AGCCS/AGCCS-CTRL22/ctrl22c/README.md

# Ctrl22C --- AVR Firmware

Our firmware for the AVR uC ATmega4808 controls the charging process according to the CCS standard. For details of the circuitry, see [../circuit](../circuit/).  The code is organised in a cyclic fashion, i.e., there is one indefinite while-loop which runs a number of callback functions to actually operate the attached hardware modules (e.g. generate control pilot CP, read back CP, read proximity pilot PP, operate mains relays, measure current, etc.). The firmware is controlled via the TX0/RX0 serial line with a line-based human-readable protocol. In our project, this control is exercised by an ESP32 SoC to allow for remote access. For first installation, we propose to set the ESP32 in target AVR development mode in order to transparently forward the AVR's TX0/RX0 via telnet; again, see [../circuit](../circuit/) for details.

## Organization of the Charging Process

The established way to charge an EV according the relevant CCS specification is organised in three stages: 

- (A) wait for the motorist to plug in the cable;
- (B) lock the charging cable, indicate available power, and wait for the EV to be ready to charge;
- (C) forward the mains power to the EV

If the maximum available mains current and the allocated phases do not change, this is exactly how our firmware behaves. However, when allocating the power dynamically, we need to take some extra precautions. The below proposal is an early draft and we expect some further tweaks to be required. To this end, it should work out fine for static power allocation.

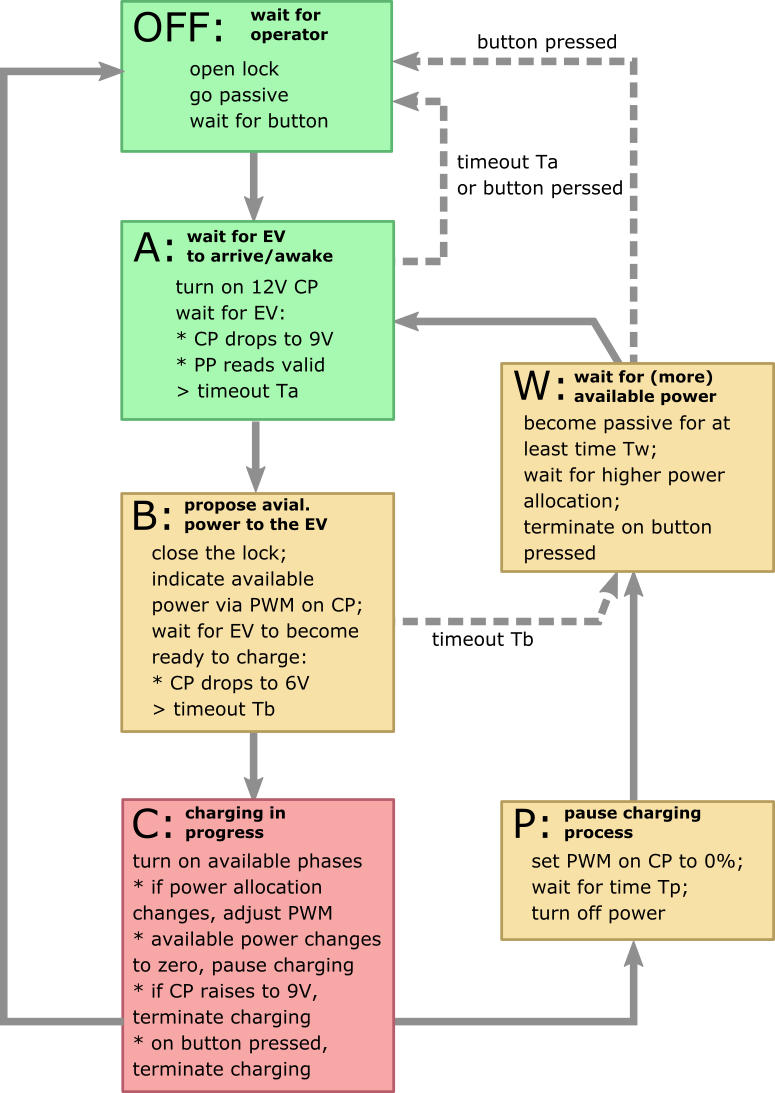
[picture p3: images/ccsfsm.png]


You can inspect the implemantation of this state machine in the callback function `ccs_cb()`. A typical cycle time of our main loop is about 5ms depending on the workload, the maximum should be below 10ms. As indicated above, the individual components are again addressed via callback functions. That is, whenever `ccs_cb()` e.g. needs to know whether the operator button has be pressed, it will read the global variable `g_button` and trust the respective callback function `button_cb()` to set this variable accordingly. By convention, global variables are prefixed `g_` and callback functions are suffixed `_cb()`. The main indefinite while loop consists of a list of callback functions which interact via dedicated global variables, i.e., the relevant state of the overall program.

- `systime_cb()` updates  `uint16_t g_systicks` to a system time in ms ticks with a convenient rollover at 2^16-1; we use `g_systicks` extensively to schedule timeouts without getting locked; there is also a variant `g_systime` with a rollover at 30000 to facilitate a synchronisation of seconds;                                     

- `monitor_cb()` is for debugging purposes, it monitors the maximum cycle time so that we can be sure to be below whatever our requirements at this end are;

- `led_blinks_cb()` outputs a flash pattern to the operator LED with a 2 second period to indicate relevant aspects of the CCS state to the customer. I.e., a single short flash at 0.5Hz for "OFF" , a 1Hz relaxed blinking for "negotiating power allocation" and a constant on for "charging". This can be overwritten via the serial line protocol.  

- `lock_cb()` operates the lock accroding to `g_lock_st`; the latter is an enum to encode `open`, `closing`, `closed` and `opening`; for convenience, there is a setter `lock(1)` to initiate closing and `lock(0)` to initiate opening; the callback then operates the solenoid according to its schedule; 

- `button_cb()` sets `g_button` to `true` when a positive edge has been detected; it will be reset in the subsequent loop;

- `rms_cb()` keeps updating the RMS measurement of the actual current; it triggers a 10kHz interrupt to take samples and subsequently organises RMS computation in short slices; eventually, `g_cur1`, `g_cur2` and `g_cur3` will be updated accordingly; the convenenience functions `rms(1)` and `rms(0)`  enable and disable RMS periodic measurement, respectively.

- `pilots_cb()` keeps updating synchronous analog reading of pilots to` g_cpilot` (scaled in [V]) and `g_ppilot` (conveniently scaled in [100mA]); again, pilot reading is enabled/disabled by  `pilots(1)`/`pilots(0)`;

## Serial Line Protocol

A relevant subsets of the state variables can be read from or written to via the serial line. It is set to 115200 8N1 and is physically accessible via J4 or, more conveniently, via telnet and the ESP32 in target development mode; see also [../citcuit](../circuit). The protocol is as follows.

- to read the parameter `<PAR>`, send `<PAR>?\r\n` to the AVR; expect a reply in the form ` <PAR>=<VAL>\r\n`, or `parse error\r\n` for a parse error; here `<PAR>` is the printable-ASCII name of the parameter and `<VAL>` is a signed 16bit integer in common decimal ASCII representation;
- to write the parameter `<PAR>`, send `<PAR>=<VAL>\r\n` to the AVR; expect a reply in the form ` <PAR>=<VAL>\r\n`, or  `parse error`; here `<PAR>` and  `<VAL>`  are ASCII encoded name and value of the respective parameter as indicated above;
- semantic suger: send `<PAR>!` to set the value to `1`, or  `<PAR>~` to clear the value to `0`.

The protocol is strictly line based. That is, the host sends one line and expects one line as reply. This is to facilitate parsing on host side, which in our use case is done by the attached ESP32.

###### Examples for the purpose of dynamic power allocation

| Send to AVR | Receive from AVR  | Comment |
| --- | --- | :--- |
| `ver?/r/n` | `ver=14/r/n` | read firmware version v1.4 |
| `cmaxcur?/r/n` | `cmaxcur=160/r/n` | read charging cable capacity 16.0A (-1 for no cable detected) |
| `smaxcur=160/r/n` | `smaxcur=320/r/n` | set maximum available current to 32.0A |
| `amaxcur?/r/n` | `amaxcur=160/r/n` | read maximum current actually allocated to the vehicle |
| `phases=12/r/n` | `phases=12/r/n` | enable mains phases L1 and L2 (i.e., decimal encoding) |
| `cur1?/r/n` | `cur1=65/r/n` | read 6.5A as current drawn on phase L1; likewise phases L2 and L3 |

**Conventions.** Current is throughout communicated by integers in the unit [100mA], i.e., fixed point representation with one decimal place when interpreted as [A]. Selection of any subset of the three phases L1, L2 and L3 is "decimal encoded", i.e., those decimal digits present in the parameter are selected. E.g., "123" reads "all three phases", "32" and "23" both read "phases L2 and L3", and "0" reads "no phases".   

Optional convenience commands are implemented on top of the strict set/get-parameter scheme. The AVR reply on such a command is escaped with a beginning line `[[[\r\n` and trailing line `]]]\r\n`. Currently, there is only one such convenience command, namely `?\r\n` to request an overall system status and the overall list of accessible global variables; see also below. 

For the sake of simplicity, the AVR is passive, i.e., if we want a regular update on some aspects of its state, we need to poll. Exceptions are

- various debug switches in our current firmware revision will generate informative lines of unsolicited rumble that begin with the special character `%`
- for future revisions, we may send relevant status updates (e.g. drawn current) by single lines that begin with the special character `[` and that end with `]/r/n`.

Thus, the ESP32 firmware shall filter any lines that start  `%` an optionally interpret lines that start with `[` .

##### List of accessible parameters as obtained by `?\r\n`

```
=======
AGCCS-Ctrl22C AVR Firmware Version 1.3
Copyright Thomas Moor (c) 2020, 2021
=======
ver=13      [R/-] % read out firmware version
blinks=-1   [R/W] % overwrite status indicator
time=1634   [R/W] % read/set systime in [ms]
temp=30     [R/-] % read AVR die temperatur [C]
vcc=3328    [R/-] % read AVR VCC [mV]
ccss=33     [R/-] % read CCS state, see typedef "ccs_state_t"
cmaxcur=320 [R/-] % read PP, i.e., max. cable capacity [100mA]
amaxcur=160 [R/-] % read max. current signaled to EV via CP [100mA]
cur1=86     [R/-] % read current drawn on L1 [10mA]
cur2=0      [R/-] % --- dito for L2
cur3=0      [R/-] % --- dito for L3
error=0     [R/-] % read error flags, see declaration "g_error"
save        [-/W] % use "save!" to save configuration to EEPROM
smaxcur=160 [R/W] % read/write max. current available from source [100mA]
brdrev=12   [R/W] % set/get board revision
ccsdmp      [-/W] % use "ccsdmp!" to track CCS state progress
phases=123  [R/W] % read/write available phases [decimal encoding]
sigrel      [-/W] % use "sigrel!"/"sigrel~" to en/disable the signal relay
pilots=1    [R/W] % use "pilots!"/"pilots~" to en/disable periodic pilot reading
cpilot=6    [R/-] % read CP [V]
cpdtest=12  [R/-] % read CP on  nagativ halfwave [-V]
ppilot=320  [R/-] % read PP (same as cmaxcur)[100mA]
cpcur=160   [R/W] % read/write max. current indicated to the EV via PWM on CP
rms=1       [R/W] % use "rms!"/"rms~" to en/disable periodic current reading
rms1=74     [R/W] % get rms reading of CT1 [mV], use "rms1!" to trigger update
rms2=3      [R/W] % --- dito for CT2
rms3=3      [R/W] % --- dito for CT3
rmsdmp      [-/W] % dump most recent rms record
caldmp      [-/W] % use "caldmp!" for periodic dumps of RMS counts (req. "rms!")
cala=1126   [R/W] % read/write calibration parameter cA
calb=271    [R/W] % read/write calibration parameter cB
lock        [-/W] % use "lock!"/"lock~" to operate the lock
lopnms=100  [R/W] % read/write pulse length to open lock [ms]
lclsms=100  [R/W] % read/write pulse length to close lock [ms]
ssr         [-/W] % operate contactors (dec. encoded), use "ssr~" for "all off"
reset       [-/W] % use "reset!" for a soft reset
=======
```

## First Installation

The firmware supports some commands via the serial line that are specifically meant to facilitate first installation. For this purpose, it is recommended to power the circuitry from a 12V bench supply and to test individual functional modules separately with dedicated test peripherals attached.

**Serial Line.** Whether physically attached via J4 and an USB-to-Serial converter (set 1o 115200 8N1)  or whether using telnet via the ESP32, enter `?\r\n` and observe the above parameter summary to verify serial communications.

**Operator LED.** Connect the LED anode to +12V and the cathode via a suitable resistor to the LED-terminal; 500R should be fine for a "standard" 2V/20mA red LED. On power up, the device will blink at a 2sec period to indicate its status. When observing continuously flashes at high frequency, this indicates an error state. On first-installation, the reason is presumably an EEPROM checksum error. This is to be fixed by saving the default parameters (command `save!\r\n`) . 

**Operator Button.** Connect the button to +12V and to the BTN-terminal. On button press, the firmware transitions to EV detection. This is indicated by changing the blink pattern of the LED to a smooth 0.5Hz blink. Since there is no EV connected, the device will go to an error state after timeout.

**Signal Relay.** By default, the signal relay is off. To turn it on, use  `sigrel!\r\n`. This is required for the following tests of the proximity signals. You should now observe +12V at the CP-terminal.

**Proximity Pilot.** Enable periodic pilot reading by `pilots!\r\n`. If nothing further is connected, `cmaxcur?\r\n` should read 130 (i.e. 13.0A). When connecting the PP-terminal via a 220R resistor to ground, `cmaxcur?\r\n` should read 320 (i.e. 32.0A). In the case the `DEBUG_ADC` macro is defined, the periodic reading of all pilots will be forwarded to the serial line, incl. the actual ADC count.

**Control Pilot (reading).** Enable periodic pilot reading by `pilots!\r\n`. If nothing further is connected, `cpilot?\r\n` should read 12 (i.e. 12V). When connecting the CP-terminal via a diode and a resistor 2.7K to ground,`cpilot?\r\n` should read 9 (i.e. 9V). When adding a 1.3K resistor in parallel `cpilot?\r\n` should read 6 (i.e. 6V). The voltage readings should match the voltage at the CP-terminal, i.e., use a meter to check back. 

**Control Pilot (generating)**. Use e.g.  `cpcur=60\r\n` to generate a 1kHz PWM signal corresponding a maximal current of 6A, which should amount to 10% duty cycle. Likewise, use  `cpcur=300\r\n` to expect a duty cycle of 50%. The amplitude should be +/-12V. Use a scope to check back. If nothing further is connected, `cpilot?\r\n` should read 12 (i.e. 12V). When connecting a diode and a resistor to the CP-terminal as described above, only the positive half wave should be affected.

**Lock.** The lock terminals W and R should be at 12V when passive. When closing the lock by  `lock!\r\n` the W terminal drops to 0V for about 100ms. If no lock is connected, this will result in a lock-error. Use   `reset!\r\n` to reset the device if you want to repeat the test. Before connecting a lock, figure the wiring (color codes differ from lock to lock). For opening the lock, use  `lock~\r\n`.

**Current Reading (A).** Use `caldmp!\r\n` to from now on forward RMS readings incl. the ADC count to the serial line. Use  `rms1!\r\n` to trigger a single reading of the RMS value for mains phase 1. The respective terminals are CT-L1 and CT-K1. Here, CT-K1 is a 1.65V bias (check with a meter) and CT-L1 is the AC signal induced by the current transformer. If nothing is connected we expect to read zero modulo noise, typical values observed are no more than 3 ADC counts.  For further testing, you may attach a signal generator with a 50Hz sine and e.g. 100mV amplitude, and check for `rms1?\r\n` to read 71 (i.e. 71mV RMS). There are two cases for consideration. If the signal generator is not grounded, you may connect directly to the CT-L1 and CT-K1 terminals. If, on the other hand, the generator is grounded, you should connect live to CT-L1 and the generators ground to GND. For this situation, you need to configure the generator to produce a 1.65V offset --- otherwise, the negative half-wave may damage the ADC in the AVR. Recall that built-in signal-generators in scopes are usually grounded. Double check the wiring and use serial resistors when connecting a signal generator to the device. 

**Current Reading (B).** The conversion from RMS in ADC counts to RMS in mV is done by the books with no calibration and we expect this to be slightly off --- the mV reading is for informative purposes only anyway. For our application, the conversion from RMS in ADC counts to RMS in multiples of 100mA is the only concern. This is implemented as an affine transformation "current [100mA]= counts x A + B".   Simple example: when reading 147 in ADC counts at an actual current of 16.2 A we may set "A=10 x 16.2 / 147" and "B=0". More advanced: reading Count1 for Current1 and Count2 for Current2, we solve "10 x Current1 = Count1 x A + B" and "10 x Current2 = Count2 x A + B" to obtain A and B. Using binary fixed point representation, the parameters A and B are specified as p_cala and p_calb in multiples of 1/1024, i.e., we finally set "p_cala=1024 x A" and "p_calb=1024 x B". For calibration you will need a full setup including the current transformers, an external current meter, and an actual load; see also [calibration](../doc/current_reading_calibration_2021_05.pdf).  

**SSRs.** To test the SSRs you will need to run the device on mains (caution!). `ssr=1\r\n` should turn on the SSR for phase 1, `ssr=123\r\n` should turn on all SSRs, `ssr~` should turn all off.   When contactors are  connected to the respective terminals Cx-N and Cx-L, they should be operated accordingly. This part of the circuitry is fairly simple and should need no further attention. We recommend not to test the SSRs beforehand and to defer this step until the entire unit is safely placed within an enclosure and contactors are attached.

**Simulating a Charging Cycle.** For a minimum setup to simulate a charging cycle, you need to install at least one contactor and one current transformer and wire this to drive some load. Since this is all on mains, installation in a proper enclosure is mandatory, incl. a CEE plug for power supply and a CCS outlet;  see [Installation](../Installation.md) for details on the external components and the wiring.  Most conveniently, you will setup an adaptor with a CCS plug on the one end such that the active phase is forwarded to an household mains outlet so you can attach a load (e.g. an electric heater). Furthermore, the adaptor should let you manually mimic the EV state via the CP line (see also above _CP reading_). Our overall setup is as follows:

```
                 external current meter  
============+                V                                           +=====
AGCCS board,|-> CCS L1 >-----O------------------> household outlet L1 --->|   
contactor,  |-> CCS N  >------------------------> household outlet N  --->| load
fuses,      |-> CCS PE >-----------------+------> household outlet PE --->|
CEE supply, |                            |                               +=====
installed   |-> CCS CP >--+--[/]--[2K7]--+ 
in a proper |             |              |
enclosure   |             +--[/]--[1K3]--+
============+             |
                          V
                    attach scope here

```

There is professional gear available for this purpose, however, at a substantial cost. At this stage it is highly recommended to connect with telnet via the ESP32 in target debug mode to access the serial line of the AVR wirelessly. Use `ccsdmp!\r\n` to observe the progress through the CCS states. Optionally, attach a scope as indicated to observe the PWM signal on the CP line. To calibrate the internal current reading, use  `caldmp!\r\n` (see also above) and compare with an external meter. 

## Compiling/Programming the AVR

We provide a `Makefile` that should be easily adaptable to Linux/MacOSX programming environments. The easiest way to get a recent AVR toolchain is to install the Arduino IDE and to figure the path of the relevant binaries. A simple `make` on the command line will then produce the binaries `ctrl22c.bin` and `ctrl22c.hex`. The former is required when updating firmware over the wireless mesh network (see [../demesh](../demesh/)), the latter when using `avrdude` via telnet or the J4 header (see [../circuit](../circuit/))

The code itself has a number of debug switches right at the beginning which we use for "serial line debugging". If e.g. there are issues with the lock, it is worth turning on `#define DEBUG_LOCK`.
