AGCCS/AGCCS-CTRL22/images/installation.pdf

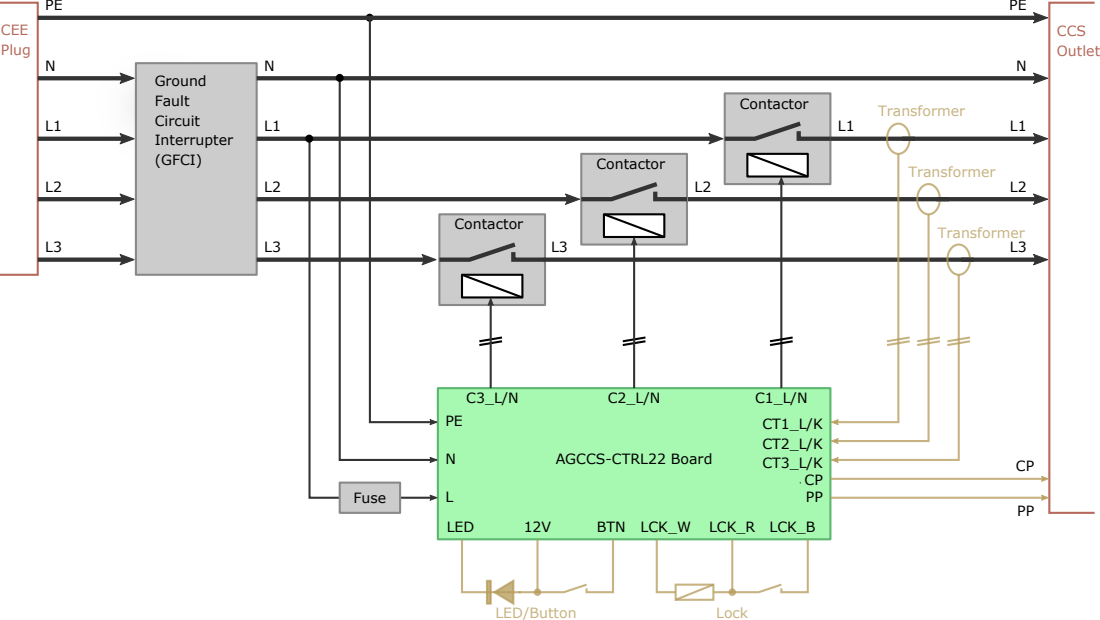
[picture p47: page 1]
Ground Fault Circuit Interrupter (GFCI); CEE Plug; Contactor; AGCCS-CTRL22 Board; CCS Outlet; LED/Button; Lock; LED; BTN; Fuse; LCK_W LCK_R LCK_B; Transformer
