AGCCS/AGCCS-CTRL22/images/installationx.pdf

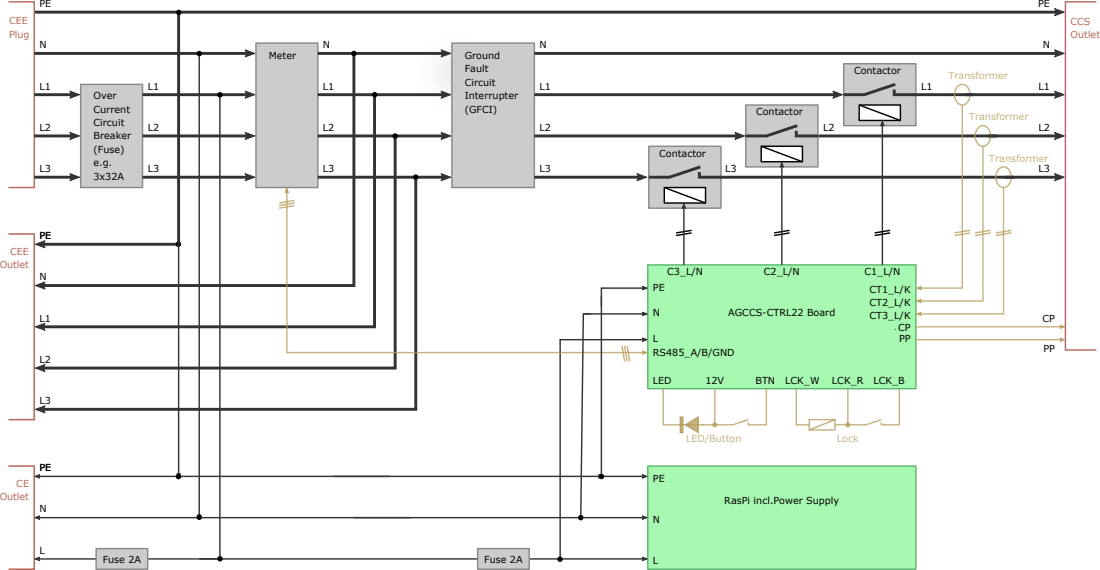
[picture p48: page 1]
Ground Fault Circuit Interrupter (GFCI); Contactor; AGCCS-CTRL22 Board; CCS Outle; PENL; C1_L/N LED/Button; Lock; LED; BTN LCK_W LCK_R LCK_B; CEE Plug; Over Current Circuit Breaker (Fuse) e.g. 3x32A; Meter; CEE Outlet; RS485_A/B/GND; PEN; CE Outlet; Fuse 2A

RasPi incl.Power Supply
