AGCCS/AGCCS-CTRL22/circuit/agccs-j5adaptor-schematic.pdf

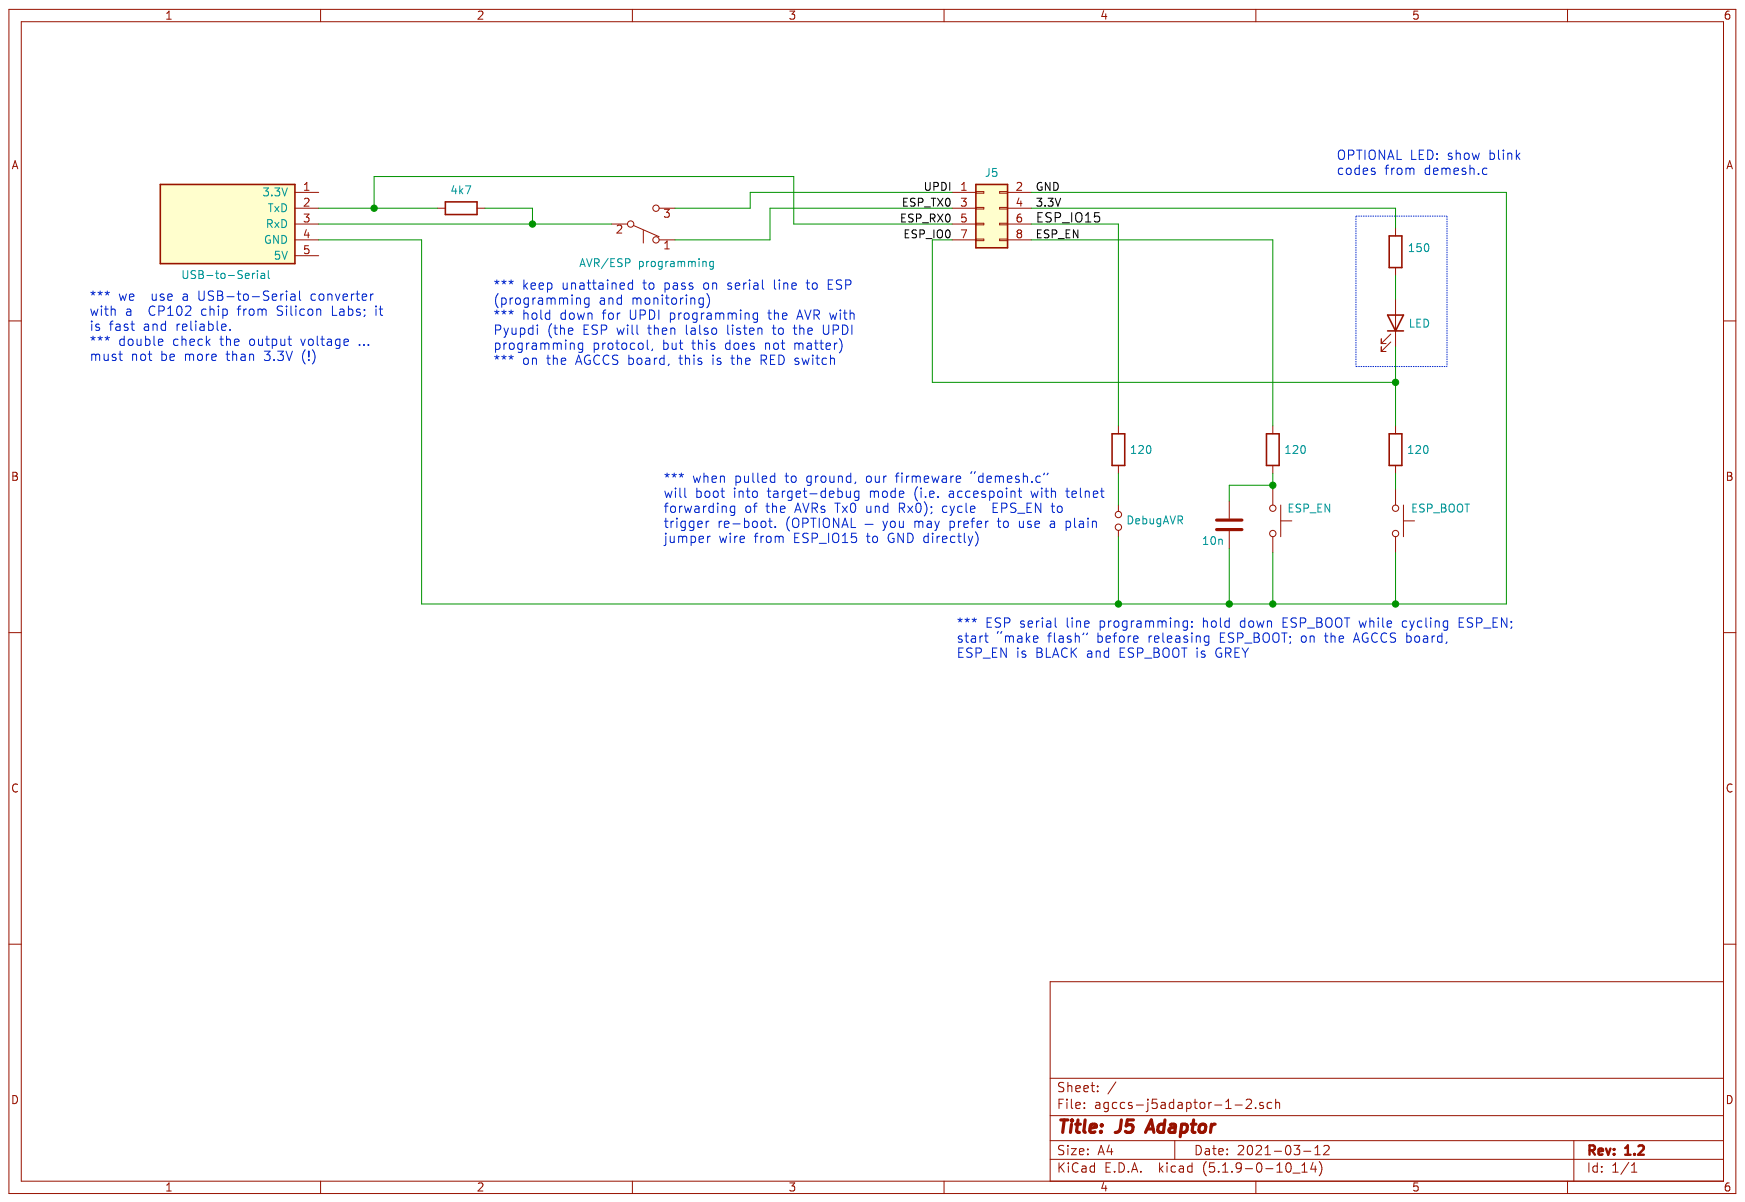
[picture p53: page 1]
