AGCCS/AGCCS-CTRL22/circuit/agccs-ctrl22-schematics.pdf

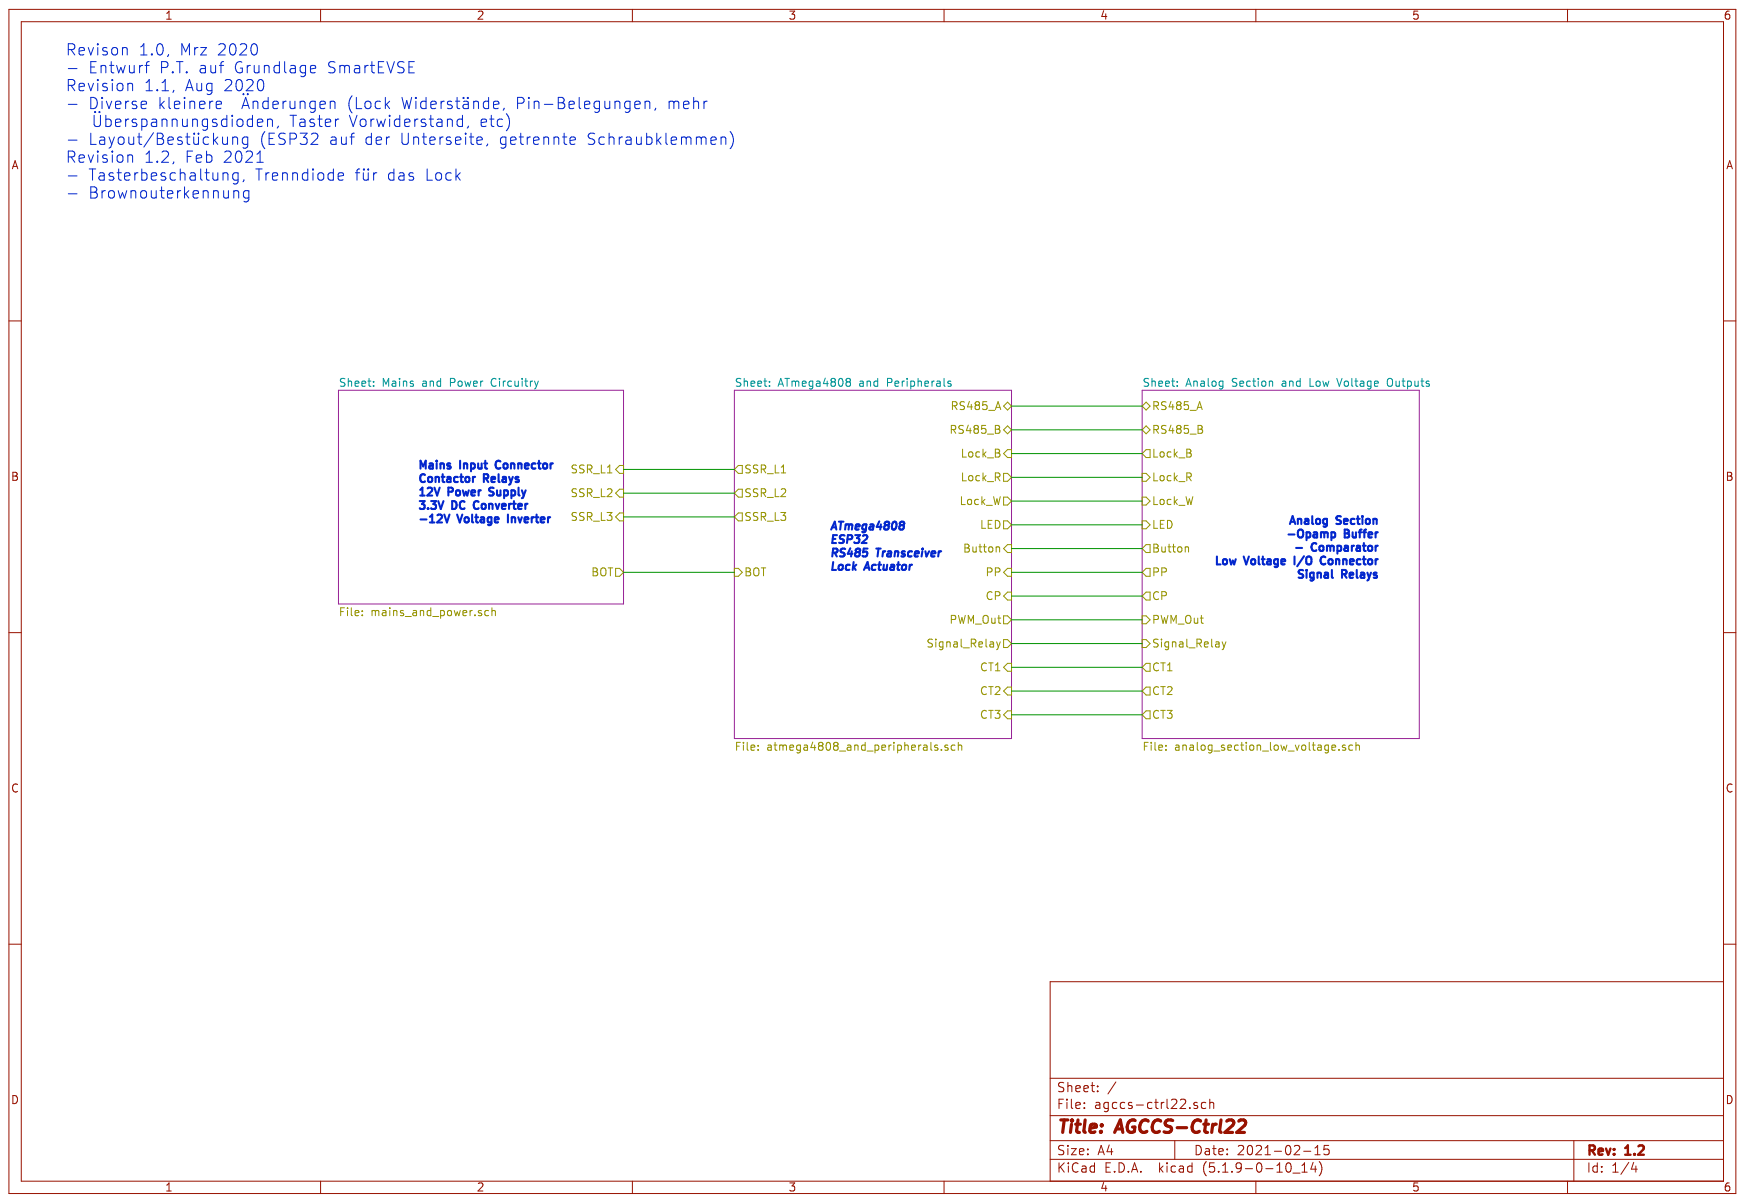
[picture p54: page 1]

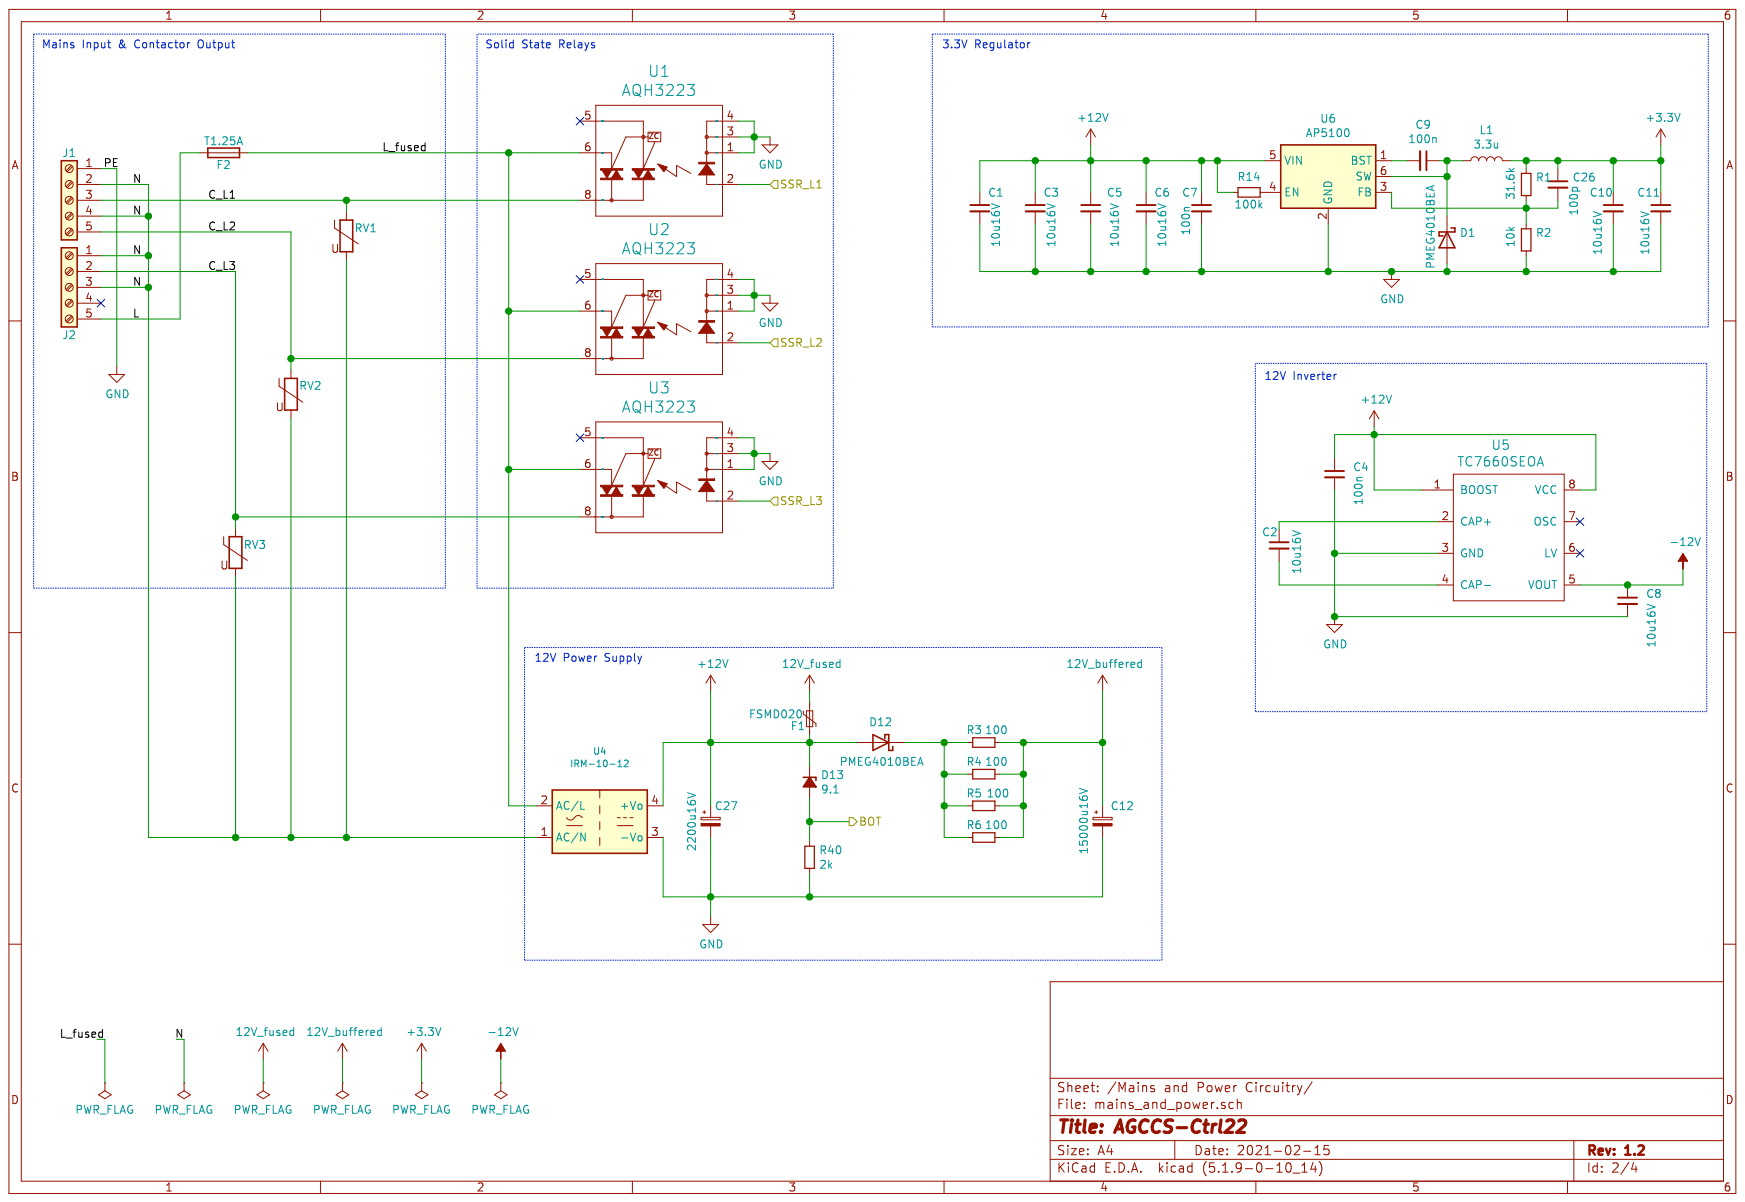
[picture p55: page 2]

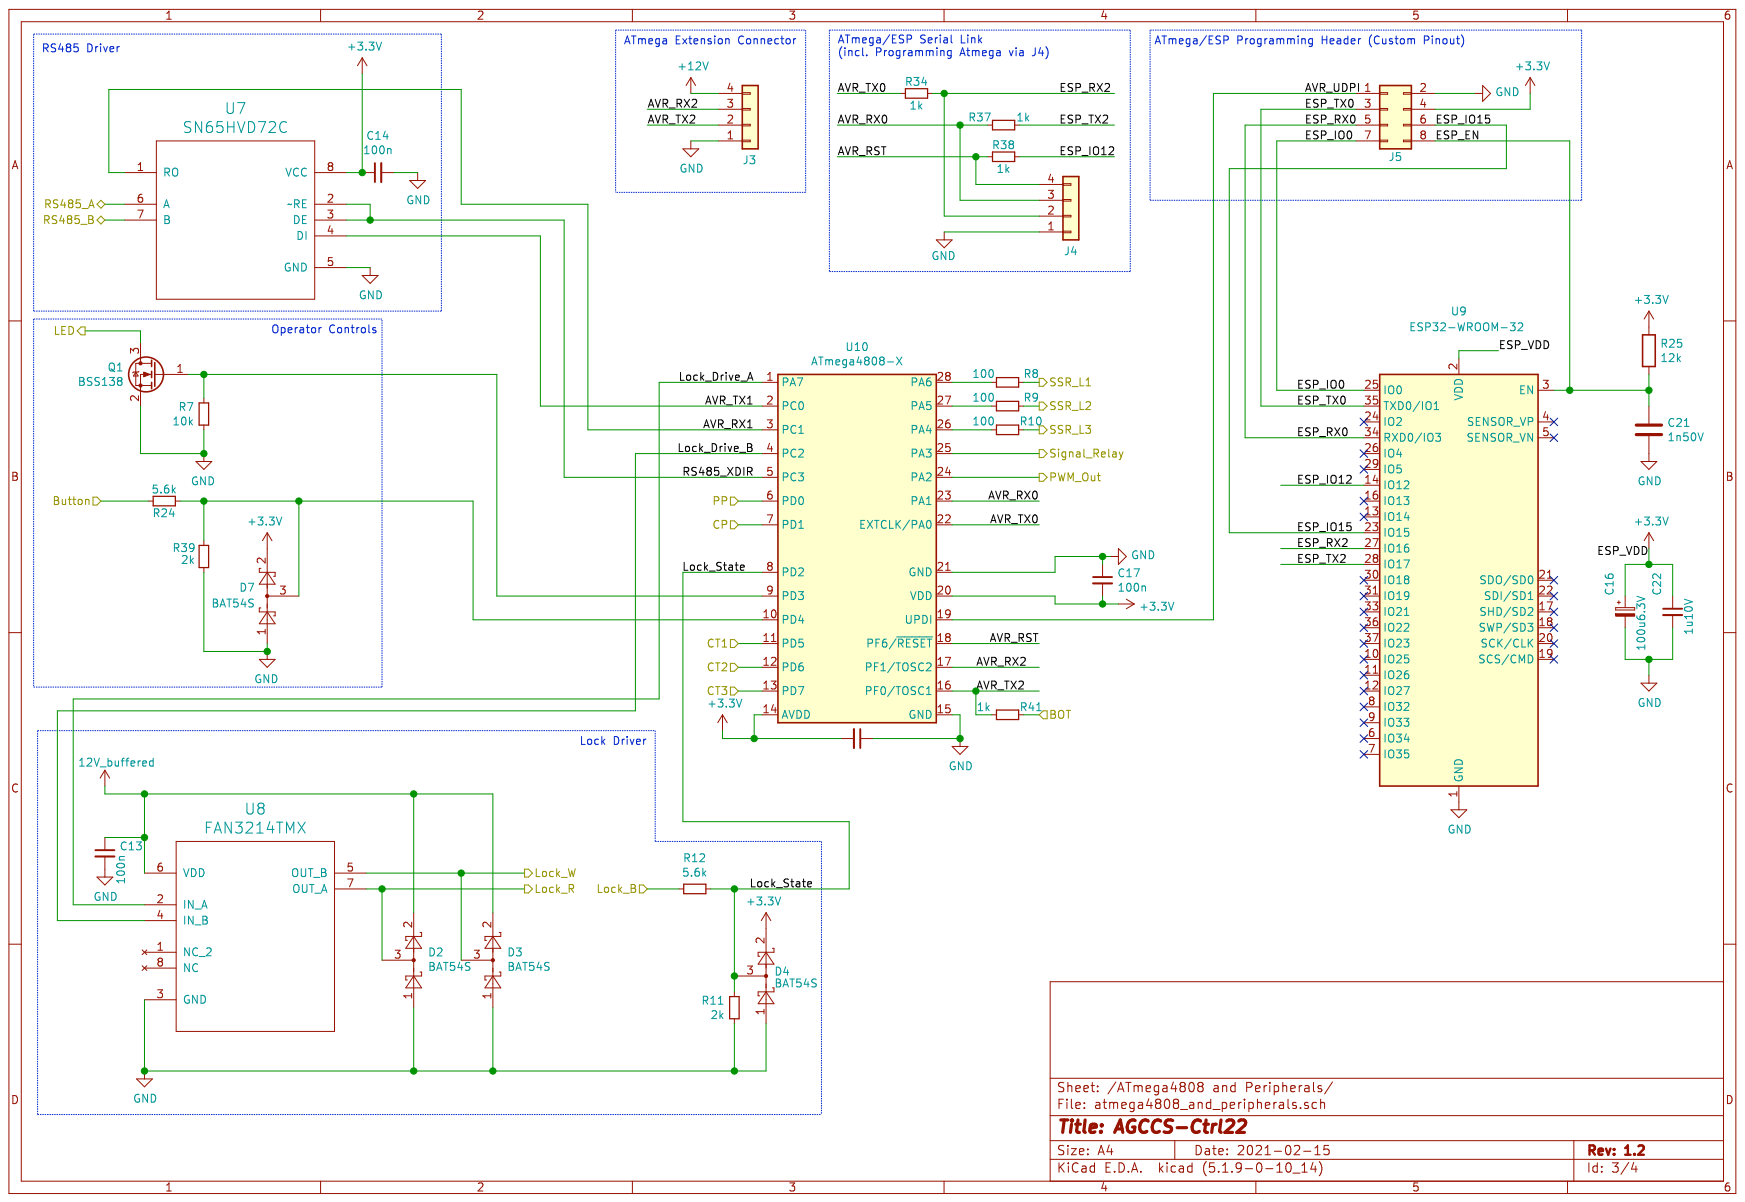
[picture p56: page 3]

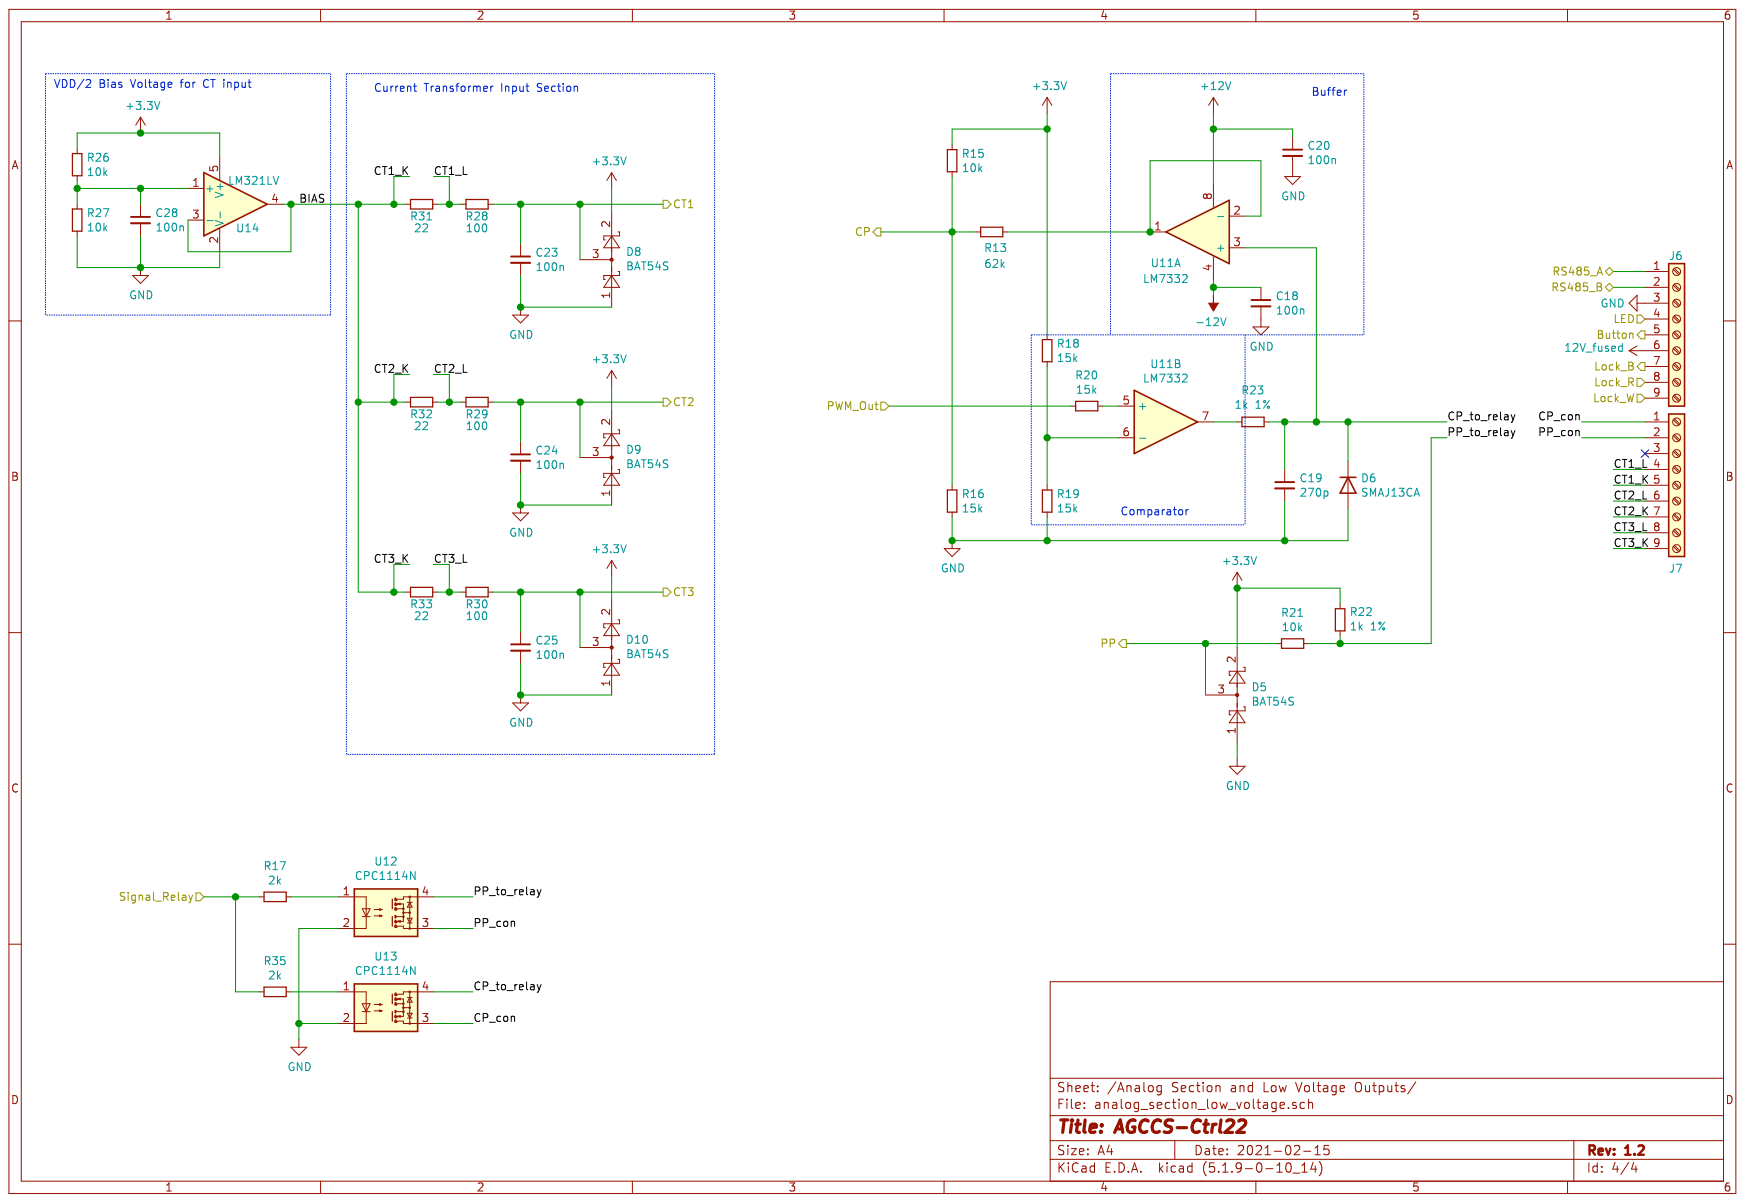
[picture p57: page 4]
