AGCCS/AGCCS-CTRL22/circuit/Rev-1-2/agccs-ctrl22-pcb-partloc.pdf

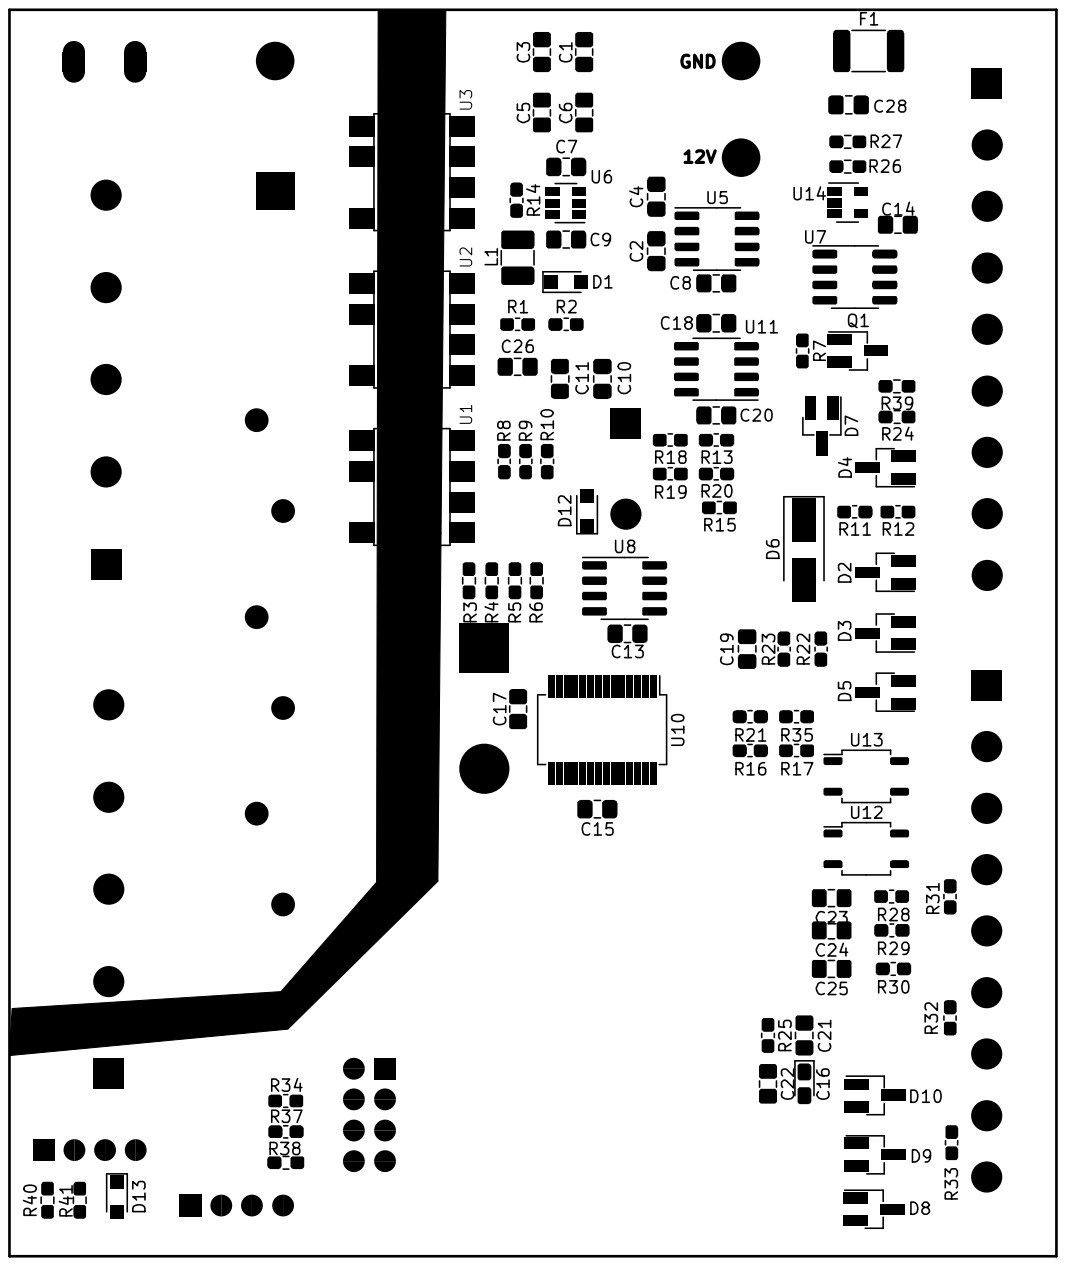
[picture p58: page 1]
