AGCCS/AGCCS-CTRL22/circuit/Rev-1-x/agccs-ctrl22.kicad_pcb

## KiCad design circuit/Rev-1-x/agccs-ctrl22.kicad_pcb (2021-03-11)

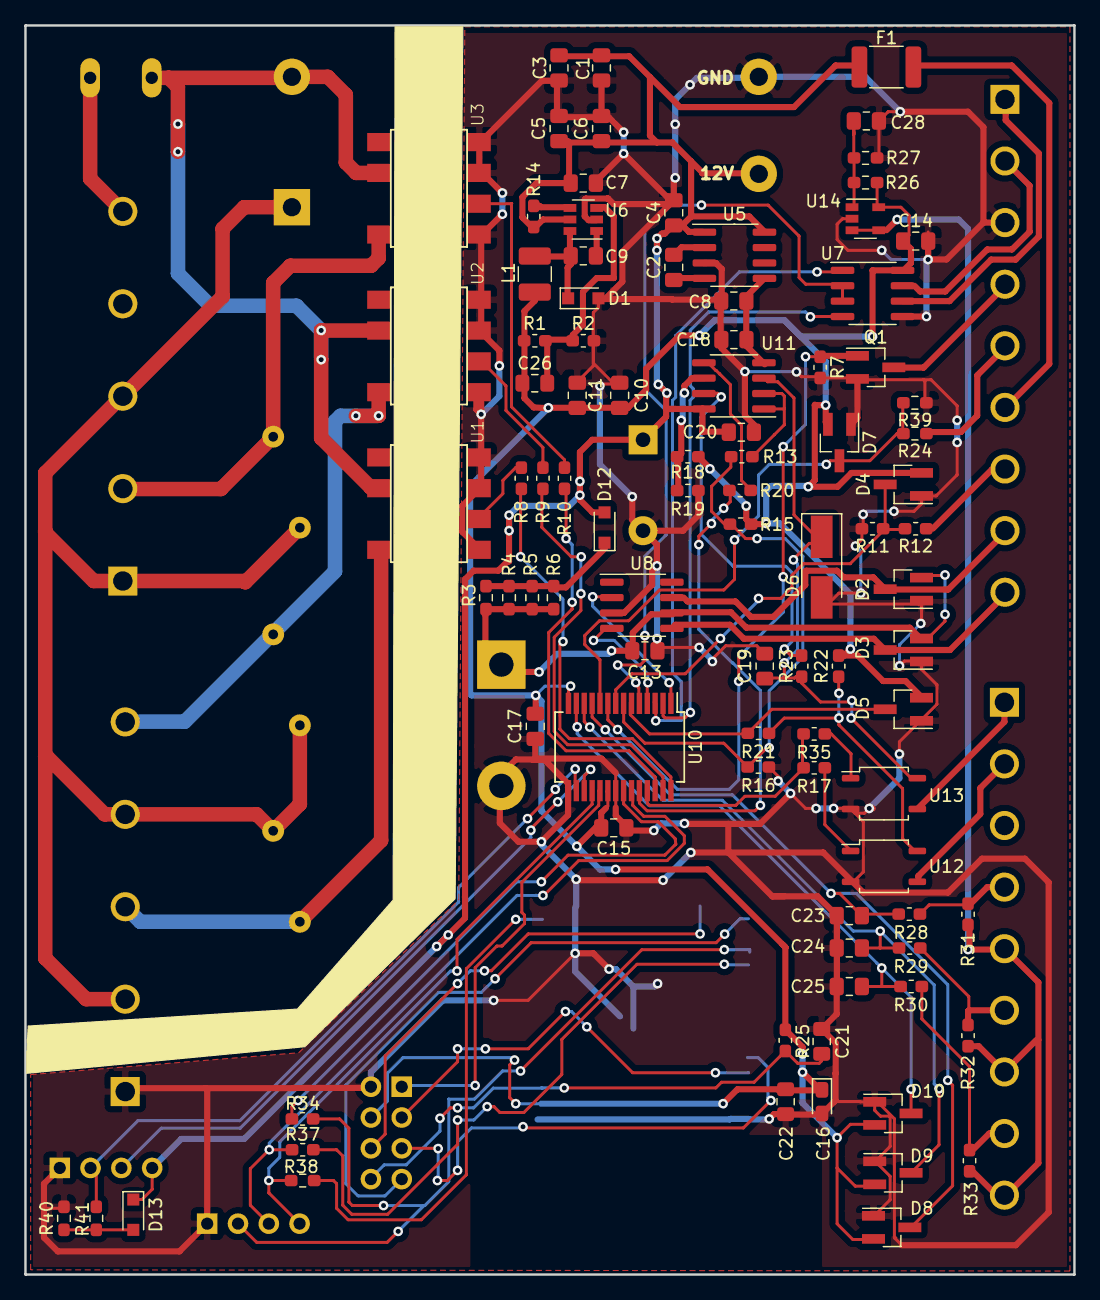
[picture p59: board agccs-ctrl22.kicad_pcb from above]

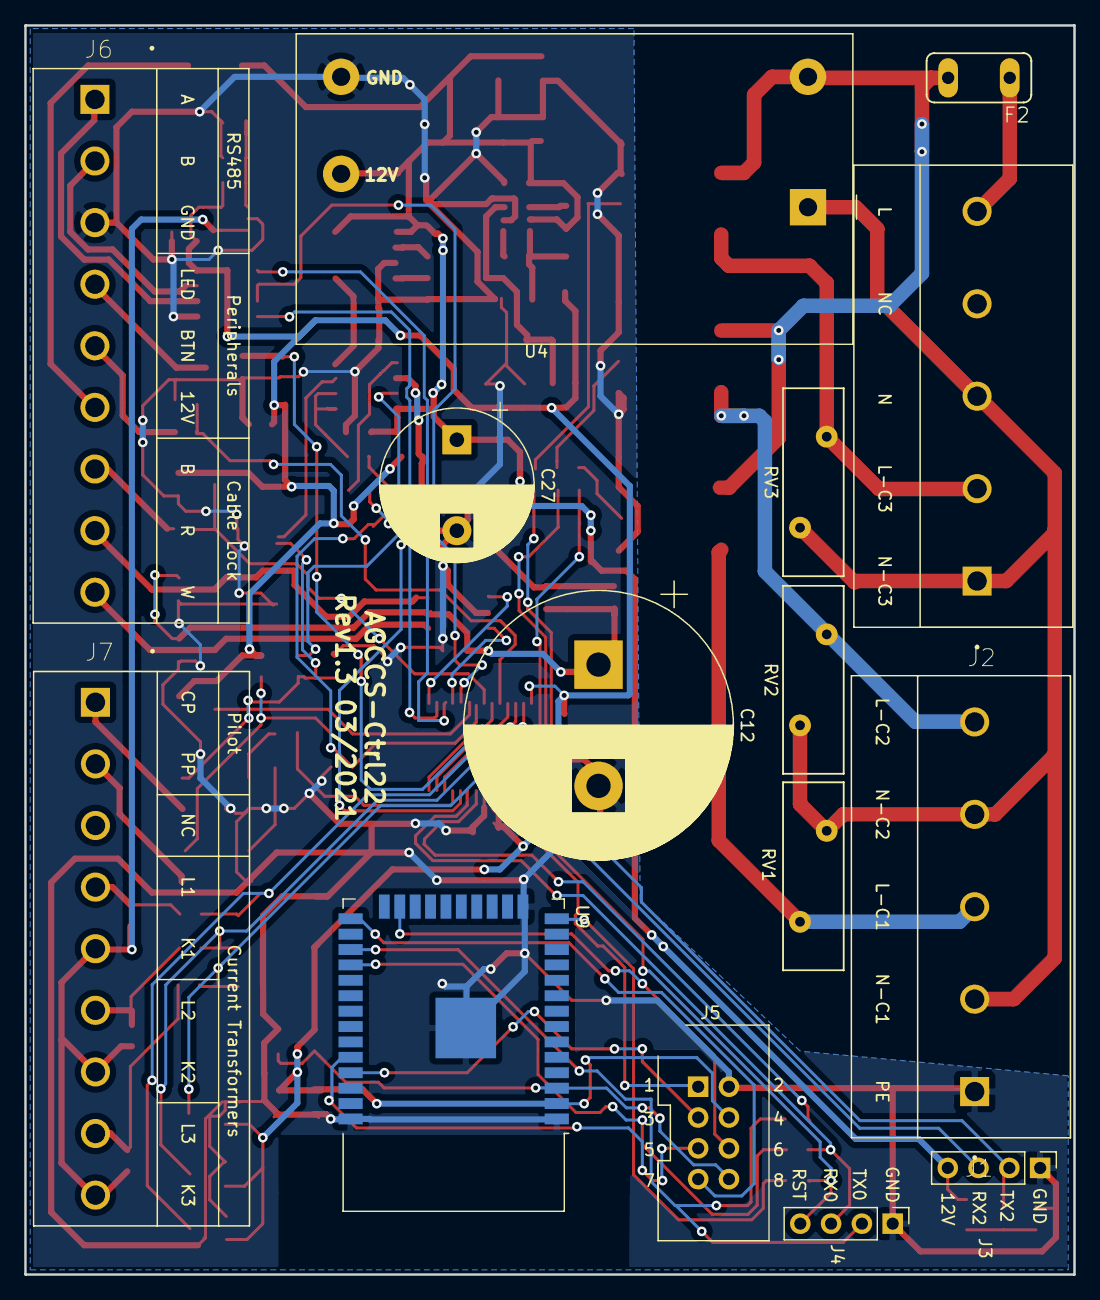
[picture p60: board agccs-ctrl22.kicad_pcb from below]

Board: 2 copper layers, 86.5 x 103.0 mm, 108 parts (15 on the bottom side), 77 nets.

Parts:
C1, C2, C3, C5, C6, C8, C10, C11: 10u16V; C_0805_2012Metric_Pad1.18x1.45mm_HandSolder
C4, C7, C9, C13, C14, C15, C17, C18, C20, C23, C24, C25, C28: 100n; C_0805_2012Metric_Pad1.18x1.45mm_HandSolder
C12: 15000u16V; CP_Radial_D22.0mm_P10.00mm_SnapIn
C16: 100u6.3V; CP_EIA-2012-15_AVX-P_Pad1.30x1.05mm_HandSolder
C19: 270p; C_0805_2012Metric_Pad1.15x1.40mm_HandSolder
C21: 1n50V; C_0805_2012Metric_Pad1.15x1.40mm_HandSolder
C22: 1u10V; C_0805_2012Metric_Pad1.15x1.40mm_HandSolder
C26: 100p; C_0805_2012Metric_Pad1.15x1.40mm_HandSolder
C27: 2200u16V; CP_Radial_D12.5mm_P7.50mm
D1, D12: PMEG4010BEA; D_SOD-323_HandSoldering
D2, D3, D4, D5, D7, D8, D9, D10: BAT54S; SOT-23_Handsoldering
D6: SMAJ13CA; D_SMA_Handsoldering
D13: 9.1; D_SOD-323_HandSoldering
F1: FSMD020; Fuse_1812_4532Metric_Pad1.30x3.40mm_HandSolder
F2: T1.25A; TE5
J1: Screw_Terminal_01x05; hv_screw_5pin_1
J2: Screw_Terminal_01x05; hv_screw_5pin_2
J3: Conn_01x04; UART2-Header
J4: Conn_01x04; UART0-Header
J5: Conn_02x04; PROGRAM-Header
J6: Screw_Terminal_01x09; lv_screw_9pin_1
J7: Screw_Terminal_01x09; lv_screw_9pin_2
L1: 3.3u; L_1210_3225Metric_Pad1.42x2.65mm_HandSolder
Q1: BSS138; SOT-23_Handsoldering
R1: 31.6k; R_0603_1608Metric_Pad1.05x0.95mm_HandSolder
R2, R7, R15, R21, R26, R27: 10k; R_0603_1608Metric_Pad1.05x0.95mm_HandSolder
R3, R4, R5, R6, R8, R9, R10, R28, R29, R30: 100; R_0603_1608Metric_Pad1.05x0.95mm_HandSolder
R11, R17, R35, R39, R40: 2k; R_0603_1608Metric_Pad1.05x0.95mm_HandSolder
R12, R24: 5.6k; R_0603_1608Metric_Pad1.05x0.95mm_HandSolder
R13: 62k; R_0603_1608Metric_Pad1.05x0.95mm_HandSolder
R14: 100k; R_0603_1608Metric_Pad1.05x0.95mm_HandSolder
R16, R18, R19, R20: 15k; R_0603_1608Metric_Pad1.05x0.95mm_HandSolder
R22, R23: 1k 1%; R_0603_1608Metric_Pad1.05x0.95mm_HandSolder
R25: 12k; R_0603_1608Metric_Pad1.05x0.95mm_HandSolder
R31, R32, R33: 22; R_0603_1608Metric_Pad1.05x0.95mm_HandSolder
R34, R37, R38, R41: 1k; R_0603_1608Metric_Pad1.05x0.95mm_HandSolder
RV1, RV2, RV3: Varistor; RV_Disc_D15.5mm_W5mm_P7.5mm
U1, U2, U3: AQH3223; DIL07SMD
U4: IRM-10-12; Converter_ACDC_MeanWell_IRM-10-xx_THT
U5: TC7660SEOA; SOIC-8_3.9x4.9mm_P1.27mm
U6: AP5100; SOT-23-6
U7: SN65HVD72C; SOIC-8_3.9x4.9mm_P1.27mm
U8: FAN3214TMX; SOIC-8_3.9x4.9mm_P1.27mm
U9: ESP32-WROOM-32
U10: ATmega4808-X; SSOP-28_5.3x10.2mm_P0.65mm
U11: LM7332; SOIC-8_3.9x4.9mm_P1.27mm
U12, U13: CPC1114N; SOP-4_3.8x4.1mm_P2.54mm
U14: LM321LV; SOT-23-5

Connections:
12V_buffered: C12.1, C13.1, D2.2, D3.2, R3.1, R4.1, R5.1, R6.1, U8.6
12V_fused: F1.2, J6.6
+3V3: C10.1, C11.1, C14.1, C15.2, C16.1, C17.2, C22.1, C26.1, D4.2, D5.2, D7.2, D8.2, D9.2, D10.2, J5.4, L1.2, R1.1, R15.1, R18.1, R22.2, R25.1, R26.1, U7.8, U9.2, U10.14, U10.20, U14.5
+12V: C1.1, C3.1, C4.1, C5.1, C6.1, C7.1, C20.1, C27.1, D12.2, D13.1, F1.1, J3.4, R14.2, U4.4, U5.1, U5.8, U6.5, U11.8
-12V: C8.1, C18.1, U5.5, U11.4
/ATmega4808 and Peripherals/AVR_RST: J4.4, R38.2, U10.18
/ATmega4808 and Peripherals/AVR_RX0: J4.3, R37.2, U10.23
/ATmega4808 and Peripherals/AVR_RX1: U7.1, U10.3
/ATmega4808 and Peripherals/AVR_RX2: J3.3, U10.17
/ATmega4808 and Peripherals/AVR_TX0: R34.2, U10.22
/ATmega4808 and Peripherals/AVR_TX1: U7.4, U10.2
/ATmega4808 and Peripherals/AVR_TX2: J3.2, R41.2, U10.16
/ATmega4808 and Peripherals/AVR_UDPI: J5.1, U10.19
/ATmega4808 and Peripherals/BOT: D13.2, R40.1, R41.1
/ATmega4808 and Peripherals/Button: J6.5, R24.1
/ATmega4808 and Peripherals/CP: R13.2, R15.2, R16.1, U10.7
/ATmega4808 and Peripherals/CT1: C23.1, D8.3, R28.1, U10.11
/ATmega4808 and Peripherals/CT2: C24.1, D9.3, R29.1, U10.12
/ATmega4808 and Peripherals/CT3: C25.1, D10.3, R30.1, U10.13
/ATmega4808 and Peripherals/ESP_EN: C21.1, J5.8, R25.2, U9.3
/ATmega4808 and Peripherals/ESP_IO0: J5.7, U9.25
/ATmega4808 and Peripherals/ESP_IO12: R38.1, U9.14
/ATmega4808 and Peripherals/ESP_IO15: J5.6, U9.23
/ATmega4808 and Peripherals/ESP_RX0: J5.5, U9.34
/ATmega4808 and Peripherals/ESP_RX2: J4.2, R34.1, U9.27
/ATmega4808 and Peripherals/ESP_TX0: J5.3, U9.35
/ATmega4808 and Peripherals/ESP_TX2: R37.1, U9.28
/ATmega4808 and Peripherals/LED: J6.4, Q1.3
/ATmega4808 and Peripherals/Lock_B: J6.7, R12.1
/ATmega4808 and Peripherals/Lock_Drive_A: U8.2, U10.1
/ATmega4808 and Peripherals/Lock_Drive_B: U8.4, U10.4
/ATmega4808 and Peripherals/Lock_R: D2.3, J6.8, U8.7
/ATmega4808 and Peripherals/Lock_State: D4.3, R11.1, R12.2, U10.8
/ATmega4808 and Peripherals/Lock_W: D3.3, J6.9, U8.5
/ATmega4808 and Peripherals/PP: D5.3, R21.2, U10.6
/ATmega4808 and Peripherals/PWM_Out: R20.2, U10.24
/ATmega4808 and Peripherals/RS485_A: J6.1, U7.6
/ATmega4808 and Peripherals/RS485_B: J6.2, U7.7
/ATmega4808 and Peripherals/RS485_XDIR: U7.2, U7.3, U10.5
/ATmega4808 and Peripherals/SSR_L1: R8.2, U1.2
/ATmega4808 and Peripherals/SSR_L2: R9.2, U2.2
/ATmega4808 and Peripherals/SSR_L3: R10.2, U3.2
/ATmega4808 and Peripherals/Signal_Relay: R17.2, R35.2, U10.25
/Analog Section and Low Voltage Outputs/BIAS: J7.5, J7.7, J7.9, R31.2, R32.2, R33.2, U14.3, U14.4
/Analog Section and Low Voltage Outputs/CP_con: J7.1, U13.3
/Analog Section and Low Voltage Outputs/CP_to_relay: C19.1, D6.1, R23.2, U11.3, U13.4
/Analog Section and Low Voltage Outputs/CT1_L: J7.4, R28.2, R31.1
/Analog Section and Low Voltage Outputs/CT2_L: J7.6, R29.2, R32.1
/Analog Section and Low Voltage Outputs/CT3_L: J7.8, R30.2, R33.1
/Analog Section and Low Voltage Outputs/PP_con: J7.2, U12.3
/Analog Section and Low Voltage Outputs/PP_to_relay: R21.1, R22.1, U12.4
/Mains and Power Circuitry/C_L1: J1.3, RV1.1, U1.8
/Mains and Power Circuitry/C_L2: J1.5, RV2.1, U2.8
/Mains and Power Circuitry/C_L3: J2.2, RV3.1, U3.8
/Mains and Power Circuitry/L: F2.2, J2.5
/Mains and Power Circuitry/L_fused: F2.1, U1.6, U2.6, U3.6, U4.2
/Mains and Power Circuitry/N: J1.2, J1.4, J2.1, J2.3, RV1.2, RV2.2, RV3.2, U4.1
GND: C1.2, C3.2, C4.2, C5.2, C6.2, C7.2, C8.2, C10.2, C11.2, C12.2, C13.2, C14.2, C15.1, C16.2, C17.1, C18.2, C19.2, C20.2, C21.2, C22.2, C23.2, C24.2, C25.2, C27.2, C28.2, D1.2, D2.1, D3.1, D4.1, D5.1, D6.2, D7.1, D8.1, D9.1, D10.1, J1.1, J3.1, J4.1, J5.2, J6.3, Q1.2, R2.2, R7.2, R11.2, R16.2, R19.2, R27.2, R39.1, R40.2, U1.1, U1.3, U1.4, U2.1, U2.3, U2.4, U3.1, U3.3, U3.4, U4.3, U5.3, U6.2, U7.5, U8.3, U9.1, U9.15, U9.38, U9.39, U10.15, U10.21, U12.2, U13.2, U14.2
unnamed: C2.1, U5.2
unnamed: C2.2, U5.4
unnamed: C9.1, D1.1, L1.1, U6.6
unnamed: C9.2, U6.1
unnamed: C26.2, R1.2, R2.1, U6.3
unnamed: C28.1, R26.2, R27.1, U14.1
unnamed: D7.3, R24.2, R39.2, U10.10
unnamed: D12.1, R3.2, R4.2, R5.2, R6.2
unnamed: Q1.1, R7.1, U10.9
unnamed: R8.1, U10.28
unnamed: R9.1, U10.27
unnamed: R10.1, U10.26
unnamed: R13.1, U11.1, U11.2
unnamed: R14.1, U6.4
unnamed: R17.1, U12.1
unnamed: R18.2, R19.1, U11.6
unnamed: R20.1, U11.5
unnamed: R23.1, U11.7
unnamed: R35.1, U13.1
